HenryM19/Final_Redes_Vehiculares/codes/Designs/controller_v1_part2.stl

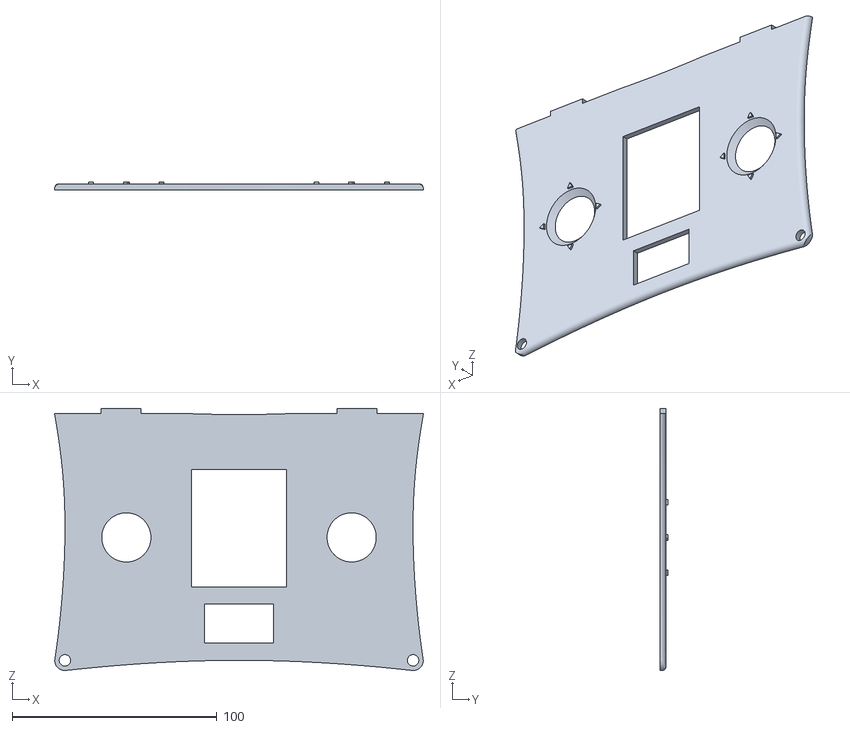
[picture p7: CAD file, 2024-07-18]
codes/Designs/controller_v1_part2.stl
180.2 x 4.00 x 128.0
