HenryM19/Final_Redes_Vehiculares/codes/Designs/desing_v4.stl

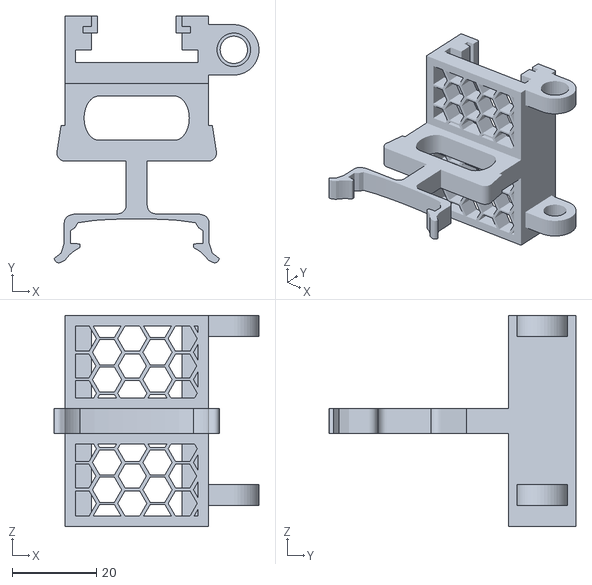
[picture p8: CAD file, 2024-07-18]
codes/Designs/desing_v4.stl
48.8 x 58.7 x 50.2
