HenryM19/Final_Redes_Vehiculares/codes/Designs/design_final.stl

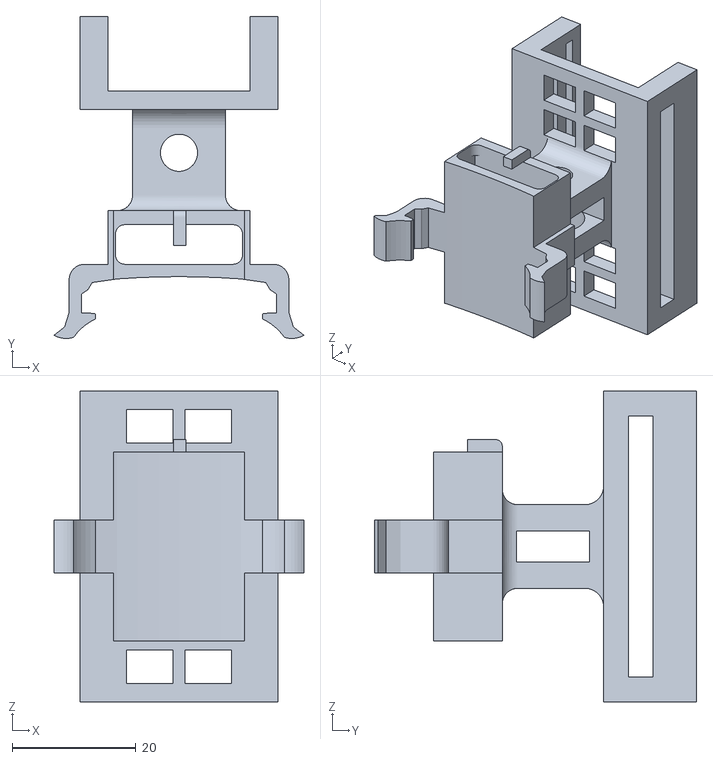
[picture p9: CAD file, 2024-07-18]
codes/Designs/design_final.stl
40.3 x 52.0 x 50.2
