HenryM19/Final_Redes_Vehiculares/codes/Designs/controller_v1_part1.stl

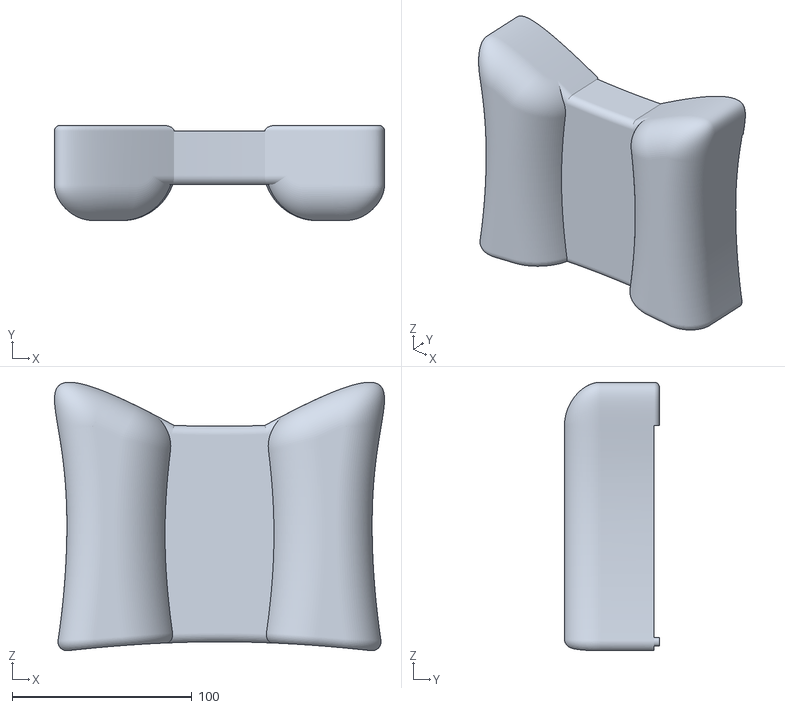
[picture p10: CAD file, 2024-07-18]
codes/Designs/controller_v1_part1.stl
183.7 x 53.0 x 149.4
