HenryM19/Final_Redes_Vehiculares/codes/Designs/design_v9.stl

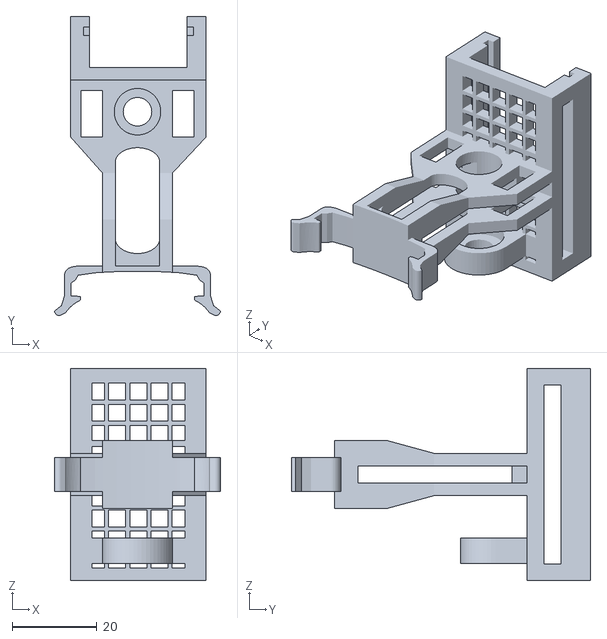
[picture p11: CAD file, 2024-07-18]
codes/Designs/design_v9.stl
39.3 x 70.7 x 50.2
