HenryM19/Final_Redes_Vehiculares/codes/Designs/design_v5.stl

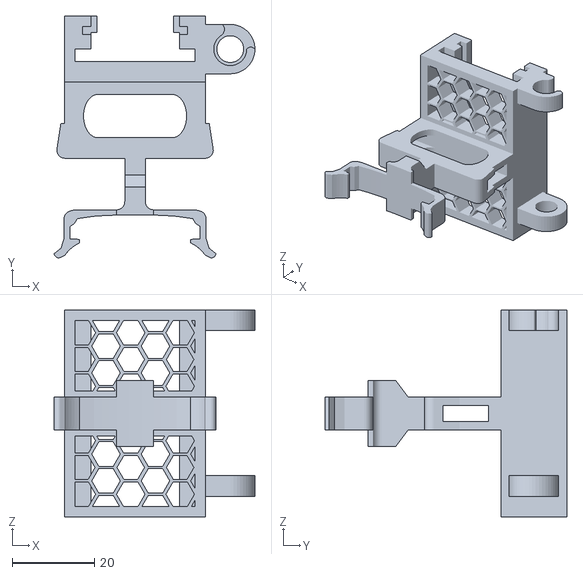
[picture p12: CAD file, 2024-07-18, an earlier design]
codes/Designs/design_v5.stl
48.8 x 58.7 x 50.2
