HenryM19/Final_Redes_Vehiculares/codes/Designs/design_v6.stl

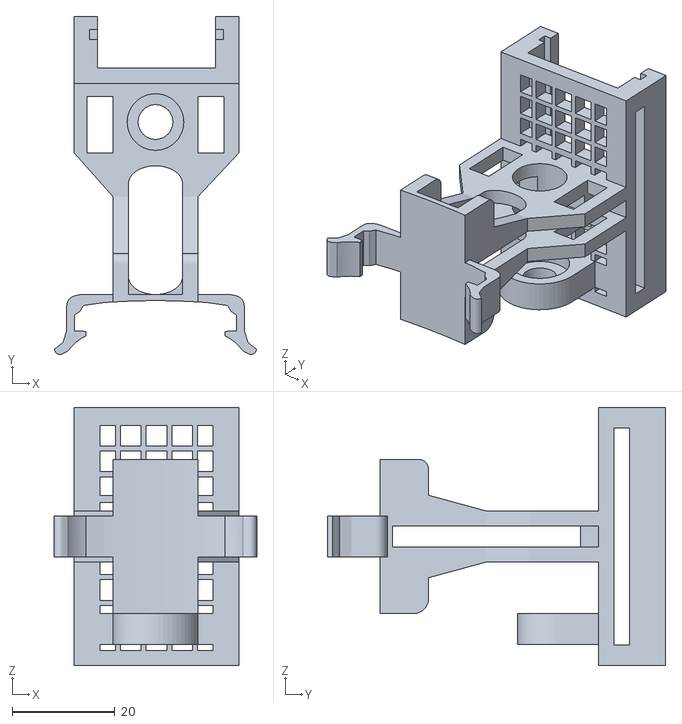
[picture p13: CAD file, 2024-07-18, an earlier design]
codes/Designs/design_v6.stl
39.3 x 65.7 x 50.2
