HenryM19/Final_Redes_Vehiculares/(list of files, cad)

Other CAD files:
codes/Designs/sujecion_final.stl
codes/Designs/design_v1.stl
codes/Designs/design_v2.stl
codes/Designs/design_v7.stl
