HenryM19/Final_Redes_Vehiculares/(commit log)

2024-07-14 Inicio de repositorio
2024-07-15 Modificación de esquema
2024-07-15 Nueva sección de Sistema de control
2024-07-18 Diseños añadidos
    [controller_v1_part1.stl, controller_v1_part2.stl, design_final.stl, design_v1.stl, design_v2.stl, design_v5.stl, design_v6.stl, design_v7.stl]
